curiouselectric/solarSoilSensor/README.md

# solarSoilSensor
An ATTiny85 based soil moisture sensor for plants

This repository contains:
* Instructions
* Schematic
* PCB files (KiCAD) & Gerbers
* HEX file
