curiouselectric/solarSoilSensor/SolarSoilSensor_PCB/2020_04_14_SolarSoilSensorPCB_Design_Board_Outline.dxf

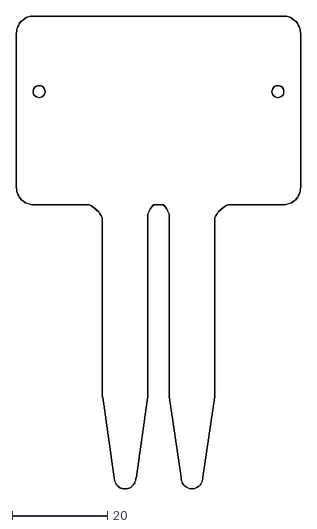
[picture p1: CAD file, 2020-07-09]
SolarSoilSensor_PCB/2020_04_14_SolarSoilSensorPCB_Design_Board_Outline.dxf
59.5 x 99.0
