curiouselectric/solarSoilSensor/SolarSoilSensor_INSTRUCTIONS/v2/SolarSoilSensor_r_v2.pdf

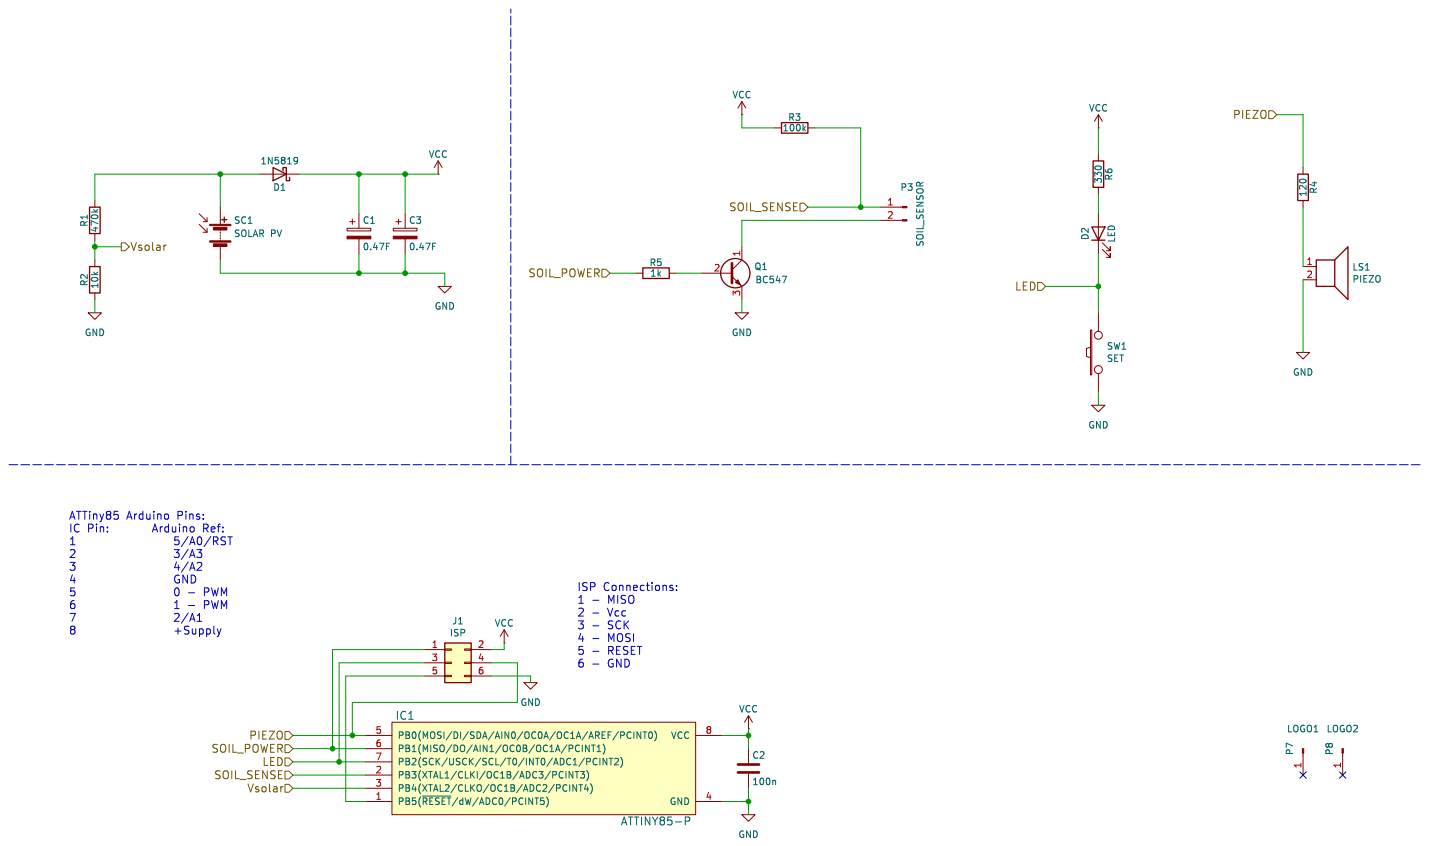
[picture p56: page 1]
