curiouselectric/solarSoilSensor/SolarSoilSensor_INSTRUCTIONS/v1-RETIRED/SolarSoilSensor_Schematic.pdf

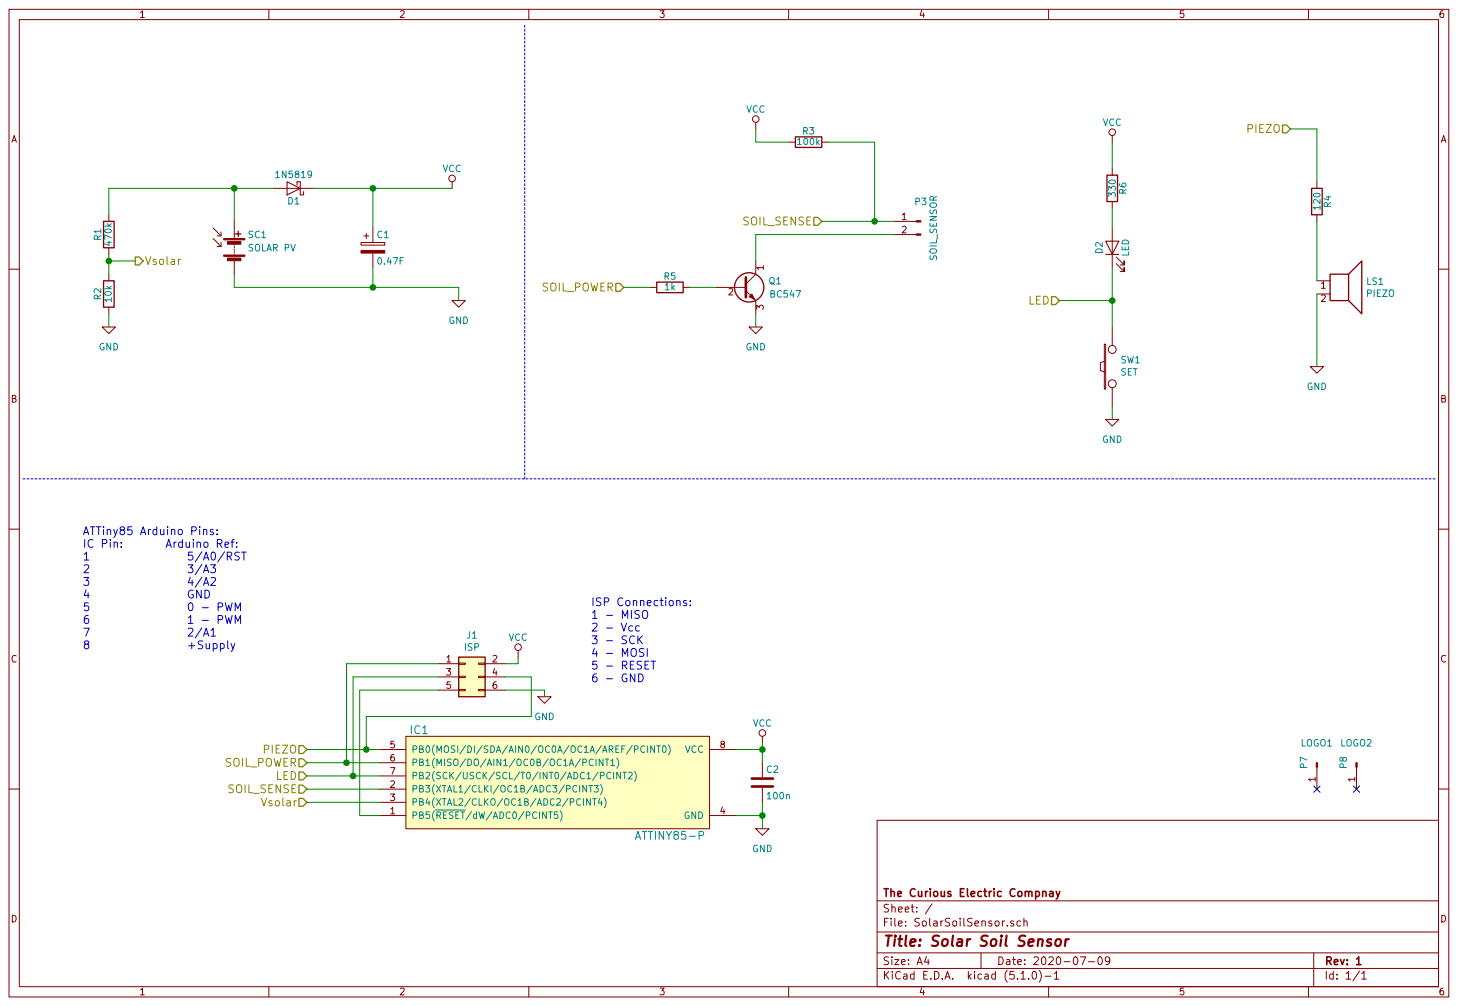
[picture p57: page 1]

Id: 1/1 Title: Solar Soil Sensor File: SolarSoilSensor.sch Sheet: / The Curious Electric Compnay
