curiouselectric/solarSoilSensor/SolarSoilSensor_PCB/Solar Soil Sensor Resistive v2/SolarSoilSensor_r_v2.kicad_pcb

## KiCad design SolarSoilSensor_PCB/Solar Soil Sensor Resistive v2/SolarSoilSensor_r_v2.kicad_pcb (2025-06-11)

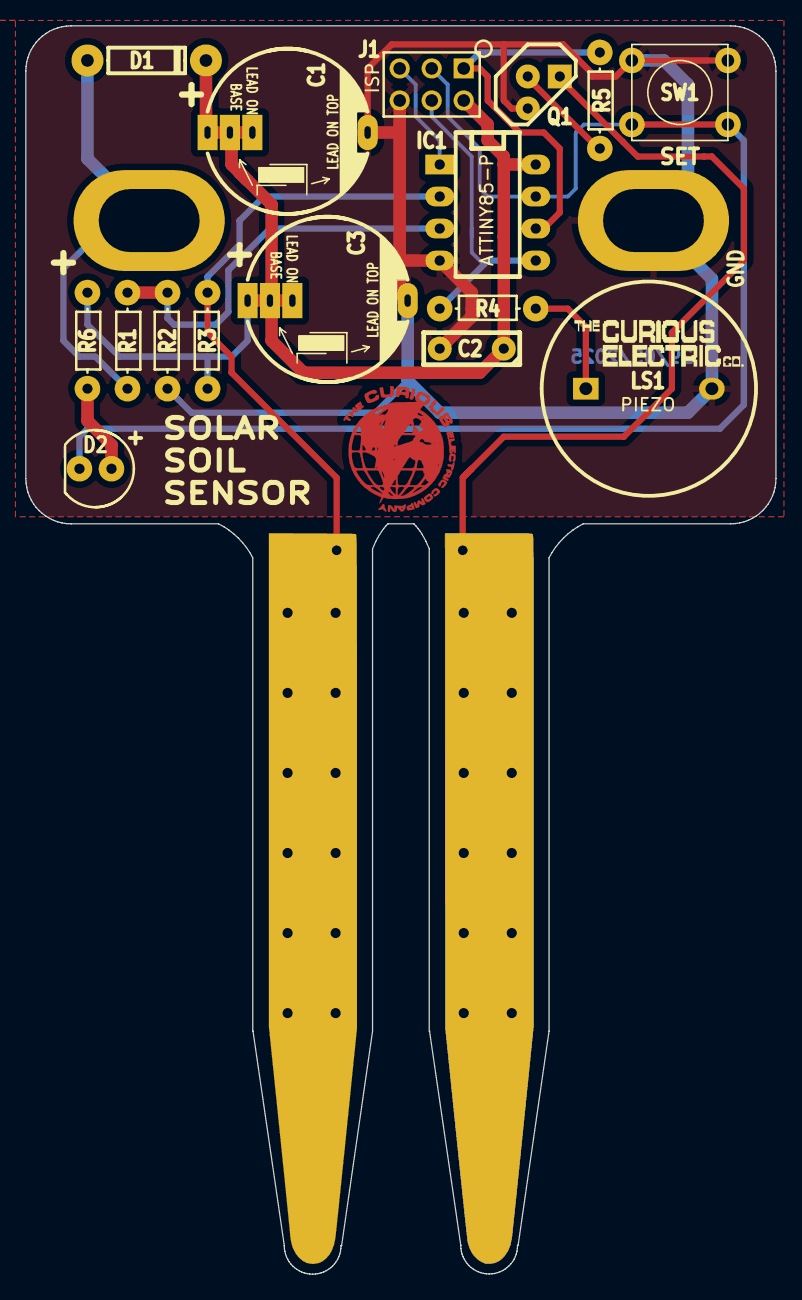
[picture p58: board SolarSoilSensor_r_v2.kicad_pcb from above]

Board: 2 copper layers, 59.5 x 99.0 mm, 20 parts (1 on the bottom side), 13 nets.

Parts:
C1, C3: 0.47F; C_0_47F_SuperCap_3POS
C2: 100n; C1_wide_lg_pad
D1: 1N5819; TH_Diode_1
D2: LED; LED-5MM_larg_pad_REV
IC1: ATTINY85-P; DIP-8_300_ELL
J1: ISP; TH3x2_ISP
LS1: PIEZO; TH_PIEZO_17x7
P3: SOIL_SENSOR; 2020_04_14_SolarSoilSensorPCB_Outline_linkedpad
P7: LOGO1; 2020_04_14_CuriousElectricCompany_Logo_Round_10mm_FCu
P8: LOGO2; TCEC_Words_13mm
Q1: BC547; TO92-EBC_large_pad
R1: 470k; TH_Resistor_1
R2: 10k; TH_Resistor_1
R3: 100k; TH_Resistor_1
R4: 120; TH_Resistor_1
R5: 1k; TH_Resistor_1
R6: 330; TH_Resistor_1
SC1: SOLAR PV; PV_53x30mm_Area
SW1: SET; SW_PUSH_SMALL_lg_pad

Connections:
/LED: D2.1 (K), IC1.7 (PB2(SCK/USCK/SCL/T0/INT0/ADC1/PCINT2)), J1.3, SW1.2
/PIEZO: IC1.5 (PB0(MOSI/DI/SDA/AIN0/OC0A/OC1A/AREF/PCI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), J1.4, R4.1
/SOIL_POWER: IC1.6 (PB1(MISO/DO/AIN1/OC0B/OC1A/PCINT1)), J1.1, R5.1
/SOIL_SENSE: IC1.2 (PB3(XTAL1/CLKI/OC1B/ADC3/PCINT3)), P3.1, R3.2
/Vsolar: IC1.3 (PB4(XTAL2/CLKO/OC1B/ADC2/PCINT4)), R1.1, R2.2
GND: C1.2, C2.2, C3.2, IC1.4 (GND), J1.6, LS1.2, Q1.3 (E), R2.1, SC1.2 (-), SW1.1
unnamed: D1.2 (A), R1.2, SC1.1 (+)
unnamed: D2.2 (A), R6.2
unnamed: IC1.1 (PB5(~RESET/dW/ADC0/PCINT5)), J1.5
unnamed: LS1.1, R4.2
unnamed: P3.2, Q1.1 (C)
unnamed: Q1.2 (B), R5.2
VCC: C1.1, C2.1, C3.1, D1.1 (K), IC1.8 (VCC), J1.2, R3.1, R6.1
