curiouselectric/solarSoilSensor/(commit log)

2020-07-09 main file upload
    [2020_04_14_SolarSoilSensorPCB_Design_Board_Outline.dxf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]
2025-06-11 Updated with version 2. Changes to all files
    [2020_04_14_SolarSoilSensorPCB_Design_Board_Outline.dxf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]
